Heloysa-Veloso-Fernandes/Project-PCEIoT/Heloysa Veloso - PCEIoT/Project Outputs for Heloysa Veloso - PCEIoT/BOM/Bill of Materials-Heloysa Veloso - PCEIoT(Fabricação).xlsx

Line # | Name | Description | Designator | Revision Status | Quantity | Manufacturer 1 | Manufacturer Part Number 1 | Manufacturer Lifecycle 1 | Supplier 1 | Supplier Part Number 1 | Supplier Unit Price 1 | Supplier Subtotal 1
 | VJ0603Y103KXAAC | Multilayer Ceramic Capacitor, 0.01 uF, 50 V, ± 10%, X7R, 0603 [1608 Metric] | C1, C4, C5, C19 |  | 4 | Vishay | VJ0603Y103KXAAC | Volume Production
 | Capacitor 4.7µF +/-20% 10V 0603 | Chip Capacitor, 4.7µF +/-20%, 10V, 0603, Thickness 1 mm | C2, C3 |  | 2 | Kyocera AVX | 0603ZD475KAT2A
 | VJ0603Y104MXJCW1BC | Multilayer Ceramic Capacitor, 0.1 uF, 16 V, ± 20%, X7R, 0603 [1608 Metric] | C6, C7, C9, C11, C12, C13, C14, C15, C16, C17, C18, C20, C21, C22, C23, C24, C25, C26, C27, C28, C29 |  | 21 | Vishay | VJ0603Y104MXJCW1BC | Volume Production
 | C0603C101K5GACTU | Multilayer Ceramic Capacitor, 100 pF, 50 V, ï¿½ 10%, C0G (NP0), 0603 [1608 Metric] | C30 |  | 1 | KEMET | C0603C101K5GACTU | Volume Production
 | GRM188R60J106ME47D | Multilayer Ceramic Capacitor, 10 uF, 6.3 V, ± 20%, X5R, 0603 [1608 Metric] | C31 |  | 1 | Murata | GRM188R60J106ME47D | Volume Production
 | ASMT-YTB7-0AA02 | LED Tri-Color Blue/Green/Red 469nm/529nm/623nm Chip LED 6-Pin PLCC T/R | D2A, D2B, D2C |  | 3 | Avago | ASMT-YTB7-0AA02 | Volume Production
 | 19-217/R6C-AL1M2VY/3T | Chip LED, Red, 5 V, 25 mA, -40 to 85 degC, 2-Pin SMD (0603), RoHS, Tape and Reel | DS1 |  | 1 | Everlight | EL-19-217/R6C-ALM2VY/3T
 | 640456-2 | Connector 250V AC/DC 5A 2P 1 Row PCB - Vertical Mounting Polyester White | J3 |  | 1 | TE Connectivity | 640456-2 | Volume Production
 | 61302011821 | THT Vertical Socket Header WR-PHD, Pitch 2.54 mm, Single Row, 20 pins | J4, J5 |  | 2 | Wurth Elektronik | 61302011821
 | 61300811821 | Btb Conn, Rcpt, 8Pos, 1Row, 2.54Mm Rohs Compliant: Yes | J6, J7, J8, J9 |  | 4 | Wurth Elektronik | 61300811821
 | BLM21PG331SN1D | IND, Chip Ferrite Bead, 330 Ohm, +/- 25%, 1.5 A, -55 to 125 degC, 0805 (2012 Metric), Tape and Reel | L1, L2 |  | 2 | Murata | LQG15HS15NJ02D | Volume Production
 | 709670110 | Pcb Mounting, Nylon 6.6, 11Mm Rohs Compliant: Yes | M1, M2, M7, M8 |  | 4 | Wurth Elektronik | 709670110
 | 970080354 | WA-SBRII Brass Spacer Stud Metric Thread int./int. | M3, M4, M9, M10 |  | 4 | Wurth Elektronik | 970080354
 | MPMS 003 0005 PH | Mach Screw Pan Head Phillips M3 | M5, M6, M11, M12 |  | 4 | Building Fasteners | MPMS 003 0005 PH
 | CMEJ-0415-42-LP | 4.0 mm, Omnidirectional, PCB Mount, 2.0 Vdc, Elecret Condenser Microphone | MK1 |  | 1 | Same Sky | CMEJ-0415-42-LP | Volume Production
 | 22-28-4033 | KK 254 Breakaway Header Vertical 3 Circuits 0.38um Gold Selective Plating Mating Pin 6.09mm | P1 |  | 1 | Molex | 22-28-4033 | Volume Production
 | NTRV4101PT1G | NTRV4101PT1G P-channel MOSFET Transistor; 1.7 A; 20 V; 3-Pin SOT-23 | Q1, Q2, Q3 |  | 3 | onsemi | NTRV4101PT1G | Volume Production
 | Resistor 1k +/-1% 0603 100 mW | Chip Resistor, 1 KOhm, +/-1%, 0.1 W, -55 to 155 degC, 0603 (1608 Metric) | R1, R38, R41, R45 |  | 4 | Yageo Group | RC0603FR-131KL | Volume Production
 | Resistor 10k +/-1% 0603 100 mW | Chip Resistor, 10 KOhm, +/- 1%, 01 W, -55 to 155 degC, 0603 (1608 Metric) | R2, R3, R4, R8, R11, R12, R13, R14, R18, R21, R22, R23, R26, R27, R36, R37, R44 |  | 17 | Panasonic | ERJ-3EKF1002V | Volume Production
 | Resistor 0R +/- 5% 0603 100 mW | Chip Resistor, 0 Ohm, 0.1 W, -55 to 155 degC, 0603 (1608 Metric) | R5, R7, R10, R30, R31 |  | 5 | Vishay | CRCW0603-0000Z0EA
 | CRCW0603150RFKEA | SMD Chip Resistor, 150 Ohm, ± 1%, 100 mW, 0603 [1608 Metric], Thick Film, General Purpose | R15A, R15B, R15C |  | 3 | Vishay | CRCW0603150RFKEA | Volume Production
 | CRCW060350R0FKEA | SMD Chip Resistor, 50 Ohm, ± 1%, 100 mW, 0603 [1608 Metric], Thick Film, General Purpose | R16A, R16B, R16C, R17A, R17B, R17C |  | 6 | Vishay | CRCW060350R0FKEA | Volume Production
 | ERJ-3EKF2001V | SMD Chip Resistor, 2 kOhm, ï¿½ 1%, 100 mW, 0603 [1608 Metric], Thick Film, Precision | R32 |  | 1 | Panasonic | ERJ-3EKF2001V | Volume Production
 | CRCW0603470RJNEA | Res Thick Film 0603 470 Ohm 5% 0.1W(1/10W) ±200ppm/°C Pad SMD Automotive T/R | R33 |  | 1 | Vishay | CRCW0603470RJNEA | Volume Production
 | ERJ-3EKF3300V | SMD Chip Resistor, 330 Ohm, ± 1%, 100 mW, 0603 [1608 Metric], Thick Film, Precision | R34 |  | 1 | Panasonic | ERJ-3EKF3300V | Volume Production
 | CRCW06032K20FKEA | SMD Chip Resistor, 2.2 kOhm, ± 1%, 100 mW, 0603 [1608 Metric], Thick Film, General Purpose | R35, R43 |  | 2 | Vishay | CRCW06032K20FKEA | Volume Production
 | Resistor 100k +/-1% 0603 100 mW | Chip Resistor, 100 KOhm, +/- 1%, 0.1 W, -55 to 155 degC, 0603 (1608 Metric) | R39, R40 |  | 2 | Vishay | CRCW0603-100KFKEA
 | TC33X-2-104E | Cermet trimmer potentiometer, 100 kΩ, 0.1 W, SMD, on top, TC33X-2-104E | R42 |  | 1 | Bourns | TC33X-2-104E | Volume Production
 | 5033981892 | Micro SD Card Connector, Pitch 1.1 mm, 8 Position, Height 1.4 mm, -25 to 85 degC, RoHS, Tape and Reel | SKT1 |  | 1 | Molex | 503398-1892 | Volume Production
 | FSM4JSMA | Switch Tactile OFF (ON) SPST Round Button Gull Wing 0.05A 12VDC 1.57N SMD Loose Piece | SW1, SW2, SW3 |  | 3 | TE Connectivity | FSM4JSMA
 | OPT4001DTSR | High-speed high-precision digital ambient light sensor (ALS) 8-SOT-5X3 -40 to 85 | U1 |  | 1 | Texas Instruments | OPT4001DTSR | Volume Production
 | SHT40I-AD1B-R3 | Humidity And Temperature Sensor | U2 |  | 1 | Sensirion | SHT40I-AD1B-R3 | Volume Production
 | ICM-42670-P | Mems Module, 1.71-3.6 V, Lga-14 Rohs Compliant: Yes | U3 |  | 1 | TDK | ICM-42670-P | Volume Production
 | SX1509BIULTRT | IC Gpio Expander I2C 16CH 28QFN / I2C Interface 5.5V 28-PIN Qfn-ut Ep T/r | U4 |  | 1 | Semtech | SX1509BIULTRT | Volume Production
 | MS563702BA03-50 | Pressure Sensor, Barometric, 300 mbar, 1200 mbar, QFN, 8, -40 C | U5 |  | 1 | Measurement Specialties | MS563702BA03-50
 | LM4040DYM3-2.5-TR | LM4040 Series 2.5 V ±1 % Precision Micropower Shunt Voltage Reference - SOT-23 | U6 |  | 1 | Microchip | LM4040DYM3-2.5-TR | Volume Production
 | SC0918 | Raspberry Pi Pico W RP2040 | U7 |  | 1 | Raspberry Pi | SC0918
 | MAX4466EXK-T | Audio Amp Microphone 1-CH Mono Class-AB 5-Pin SC-70 T/R | U8 |  | 1 | Analog Devices Inc./Maxim Integrated | MAX4466EXK+T | Manual Solution | DigiKey | MAX4466EXK+CT-ND | 0.88 | 0.88
 | MCP73831T-2ACI/OT | MCP73831 Series Single-Cell Li-Ion/Li-Polymer Battery Charge Controller SOT-23-5 | U9 |  | 1 | Microchip | MCP73831T-2ACI/OT | Volume Production
 | BQ29700DSER | Li-Ion/Li Polymer Advanced Single-Cell Battery Protector IC Family 6-WSON -40 to 85 | U10 |  | 1 | Texas Instruments | BQ29700DSER | Volume Production
