Heloysa-Veloso-Fernandes/Project-PCEIoT/Heloysa Veloso - PCEIoT/Project Outputs for Heloysa Veloso - PCEIoT/Heloysa Veloso - PCEIoT.pdf

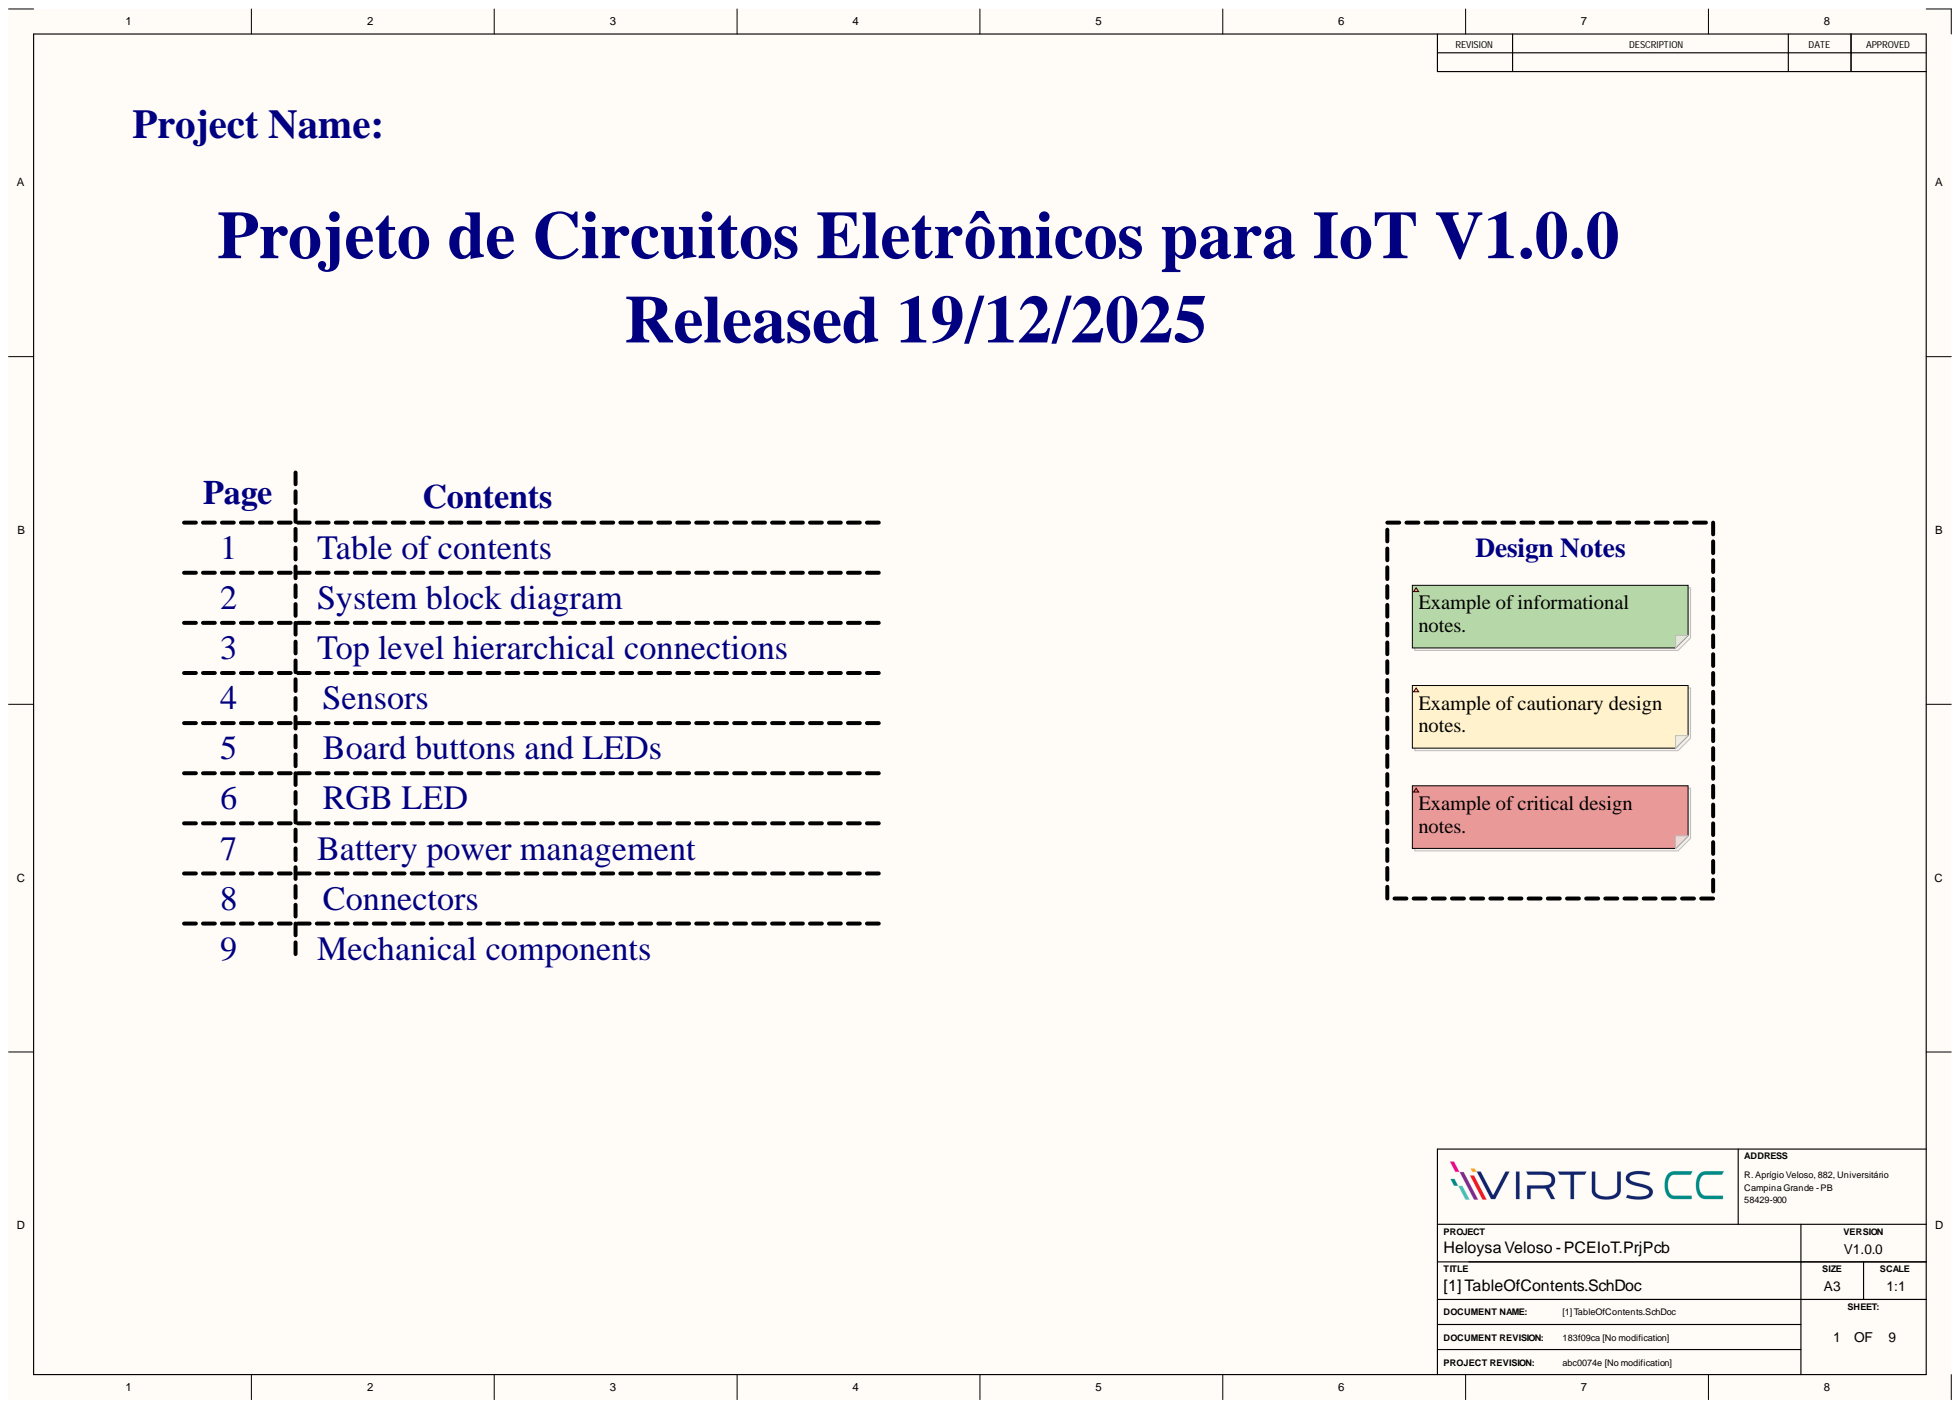
[picture p1: page 1]

Project Name:
Projeto de Circuitos Eletrônicos para IoT V1.0.0

Example of cautionary design
notes.

Example of critical design

ADDRESS R.Aprígio Veloso, 882, Universitário Campina Grande - PB 58429-900

PROJECT Heloysa Veloso - PCEIoT.PrjPcb | VERSION V1.0.0

TITLE [1] TableOfContents.SchDoc | SIZE A3 | SCALE 1:1

DOCUMENT NAME: [1] TableOfContents.SchDoc | SHEET: OF

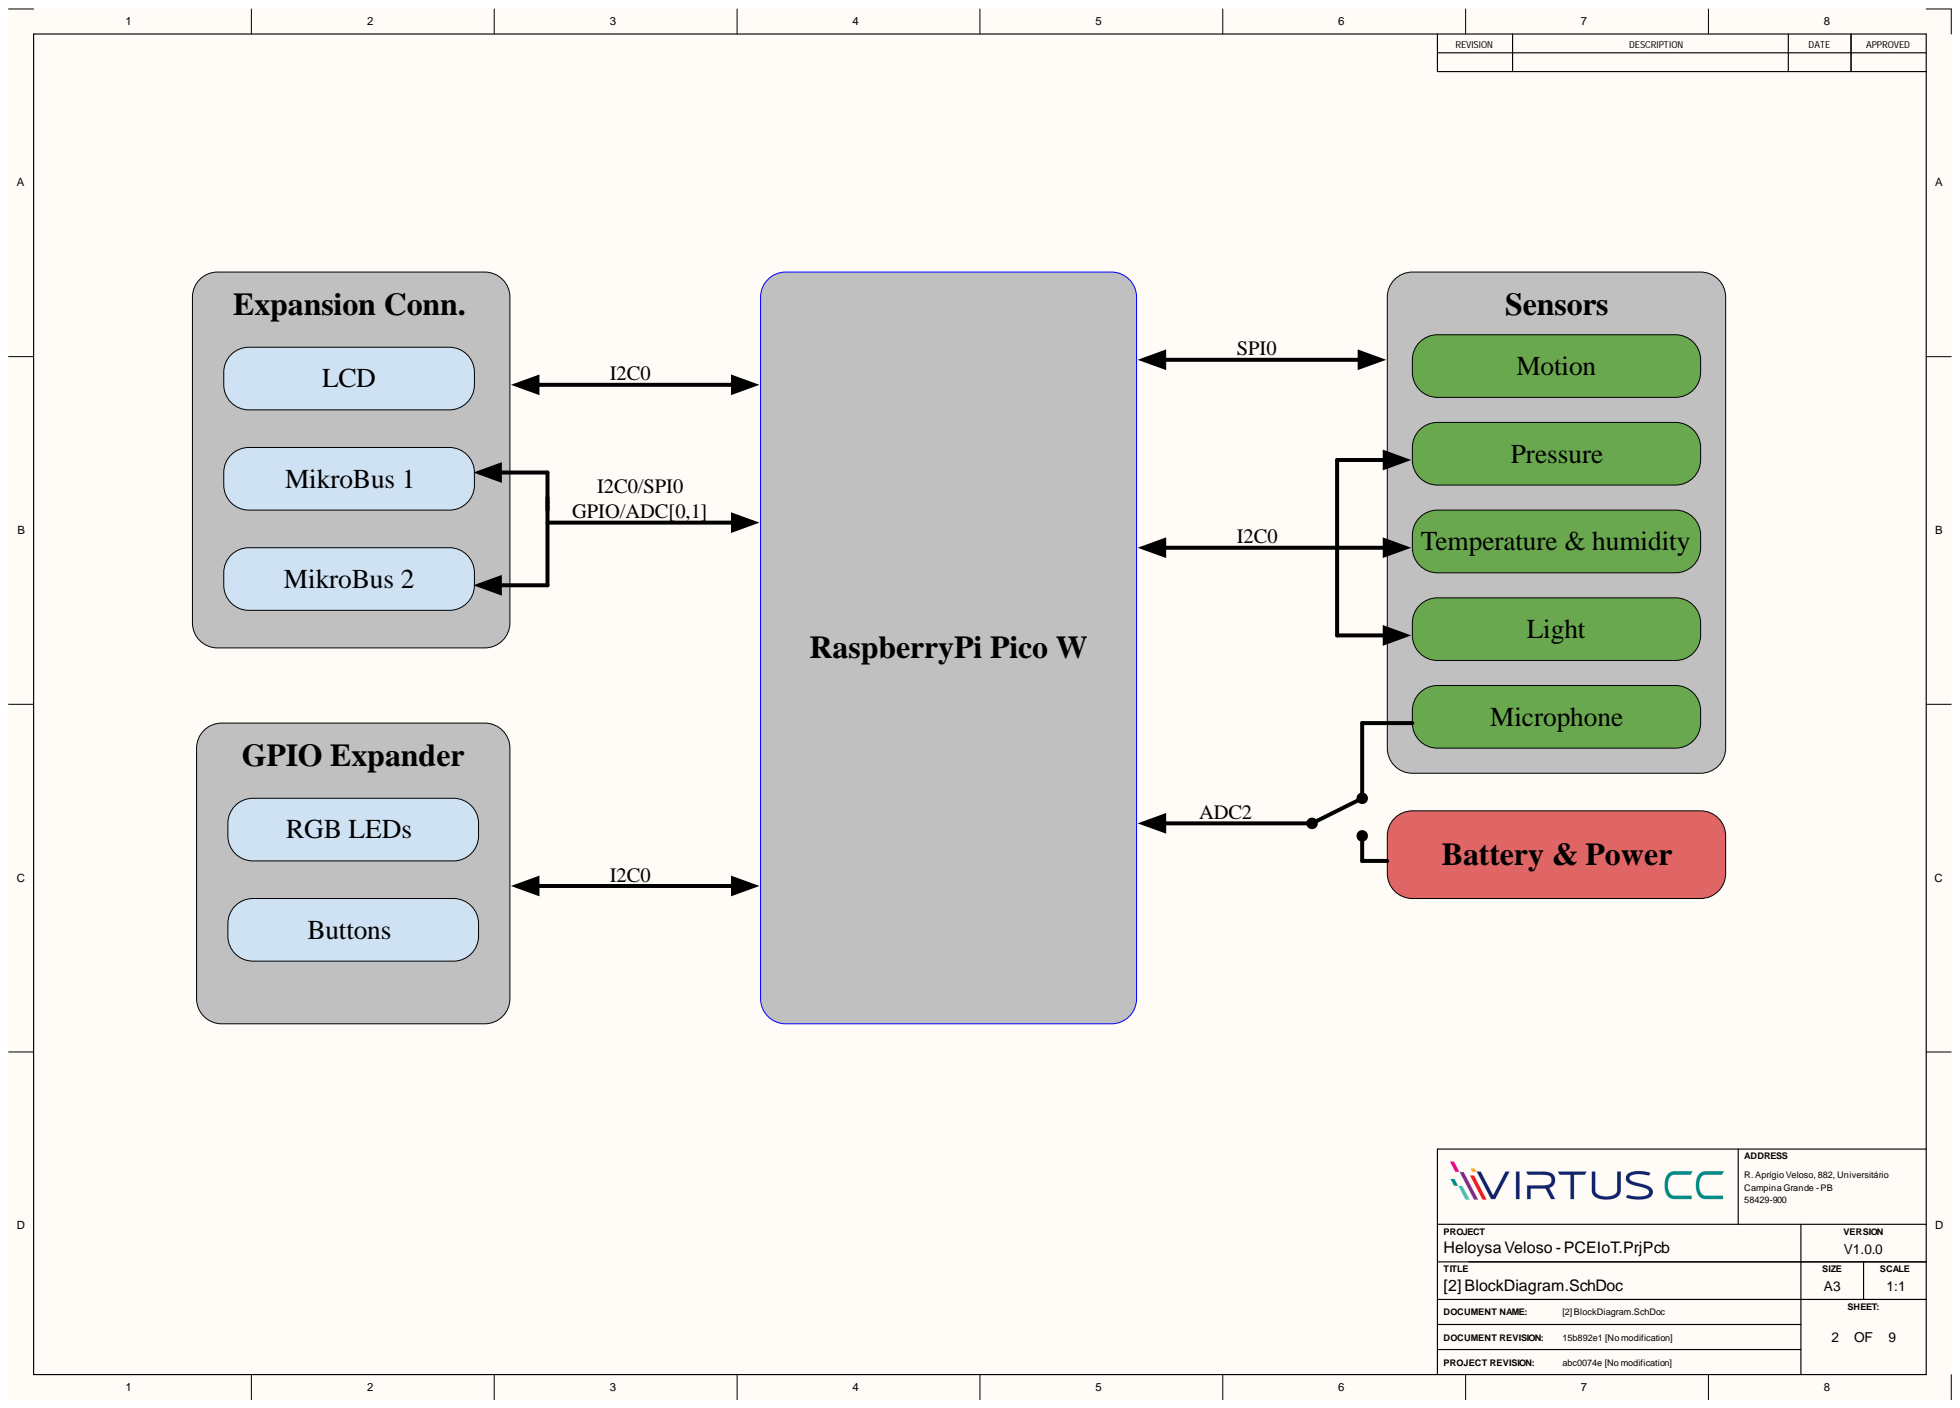
[picture p2: page 2]

ADDRESS R.Aprígio Veloso, 882, Universitário Campina Grande - PB 58429-900

PROJECT Heloysa Veloso - PCEIoT.PrjPcb | VERSION V1.0.0

TITLE [2] BlockDiagram.SchDoc | SIZE A3 | SCALE 1:1

[2] BlockDiagram.SchDoc

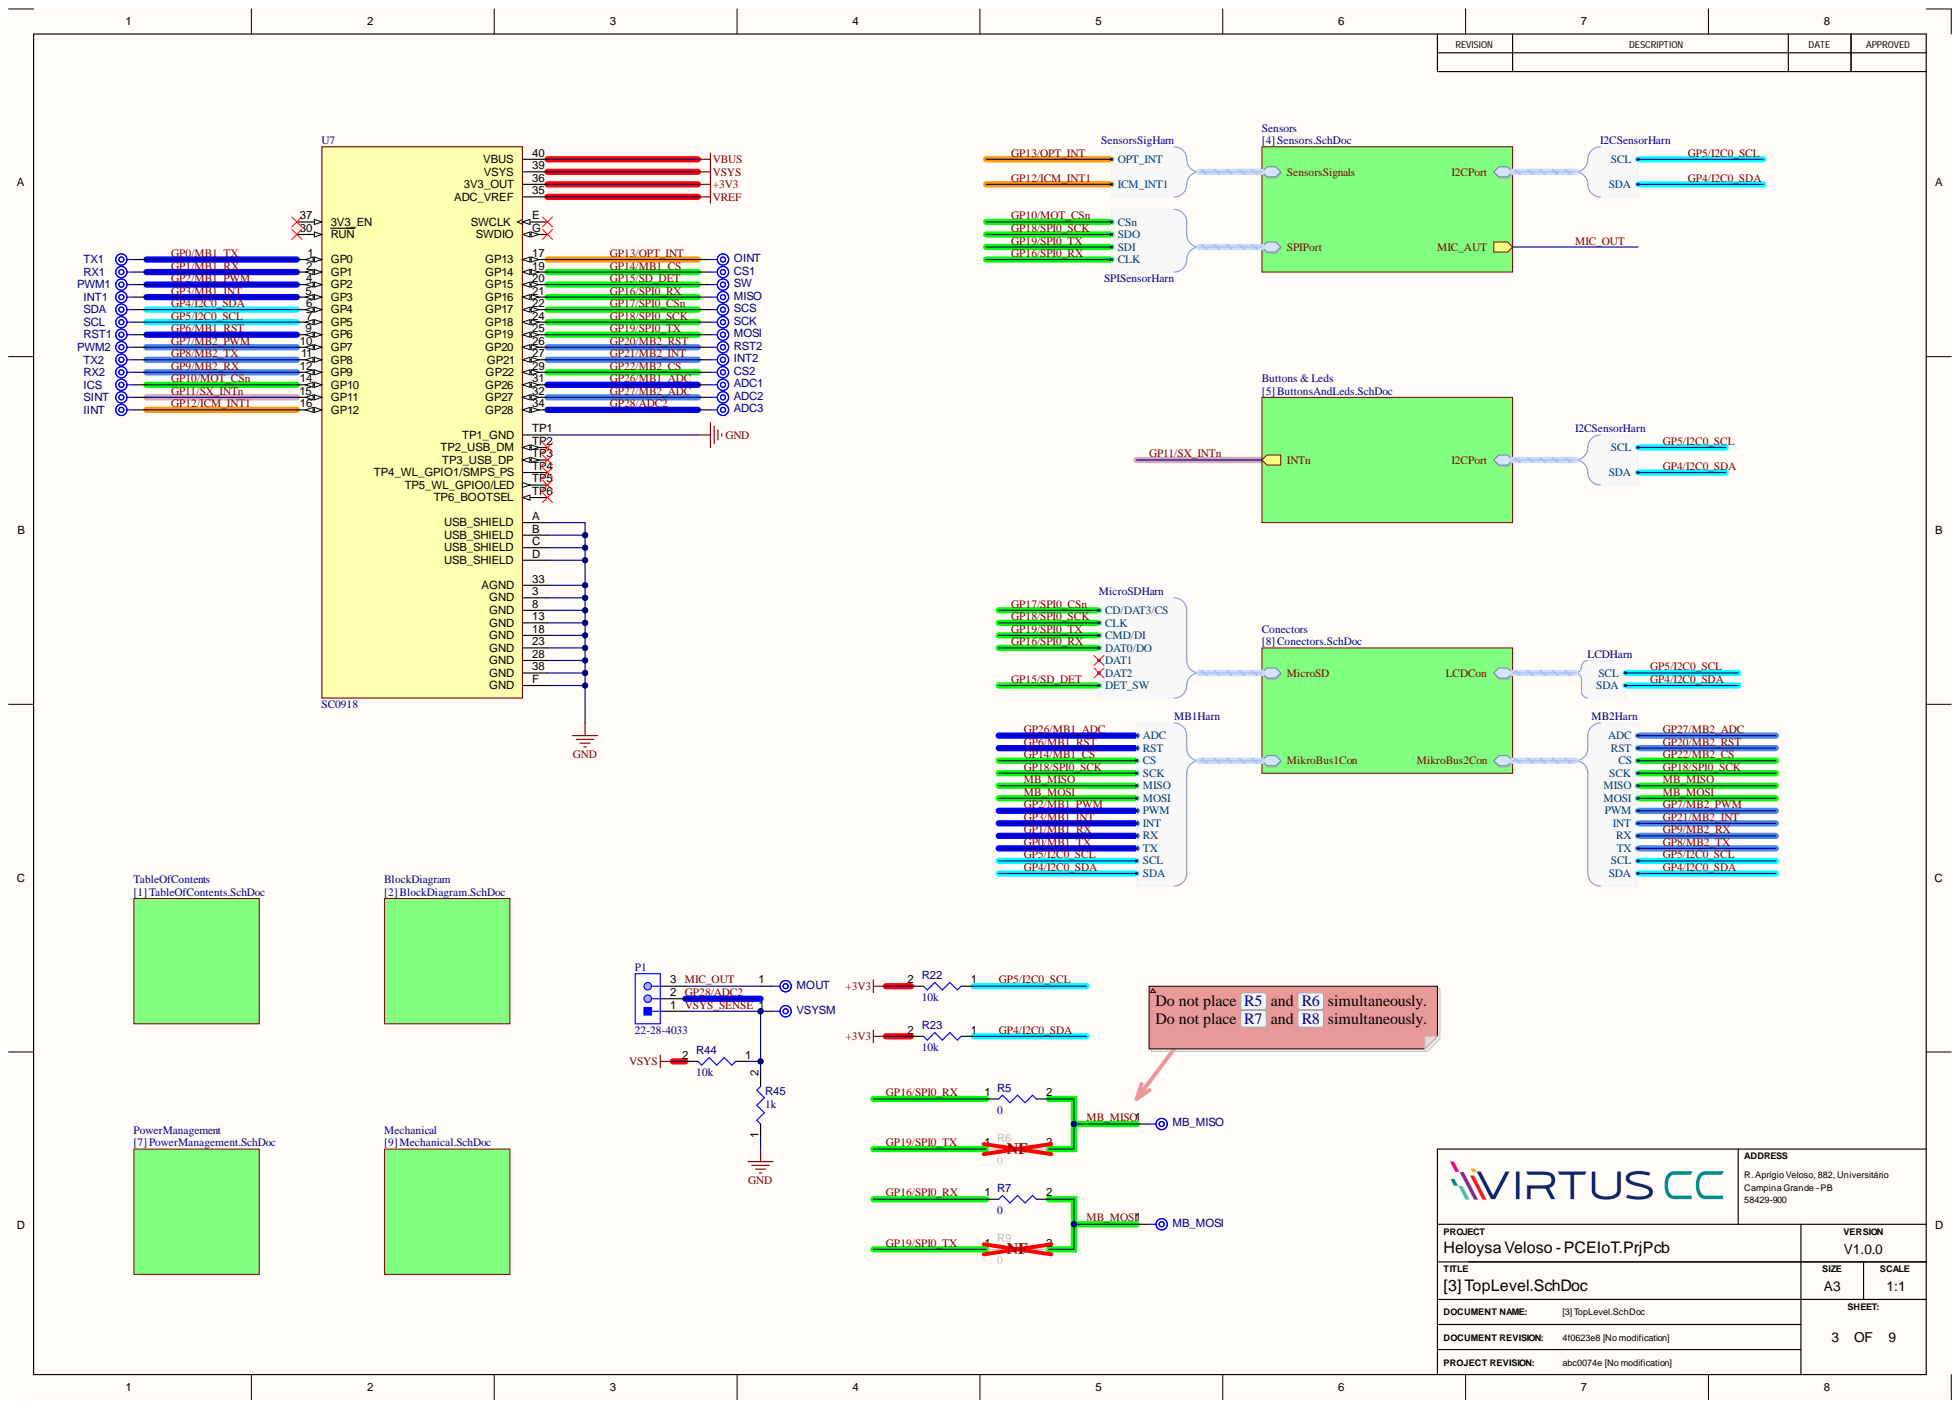
[picture p3: page 3]

Do not place R5 and R6 simultaneously.
Do not place R7 and R8 simultaneously.

ADDRESS R.Aprígio Veloso, 882, Universitário Campina Grande - PB 58429-900

PROJECT Heloysa Veloso - PCEIoT.PrjPcb | VERSION V1.0.0

TITLE [3] TopLevel.SchDoc | SIZE A3 | SCALE 1:1

[3] TopLevel.SchDoc

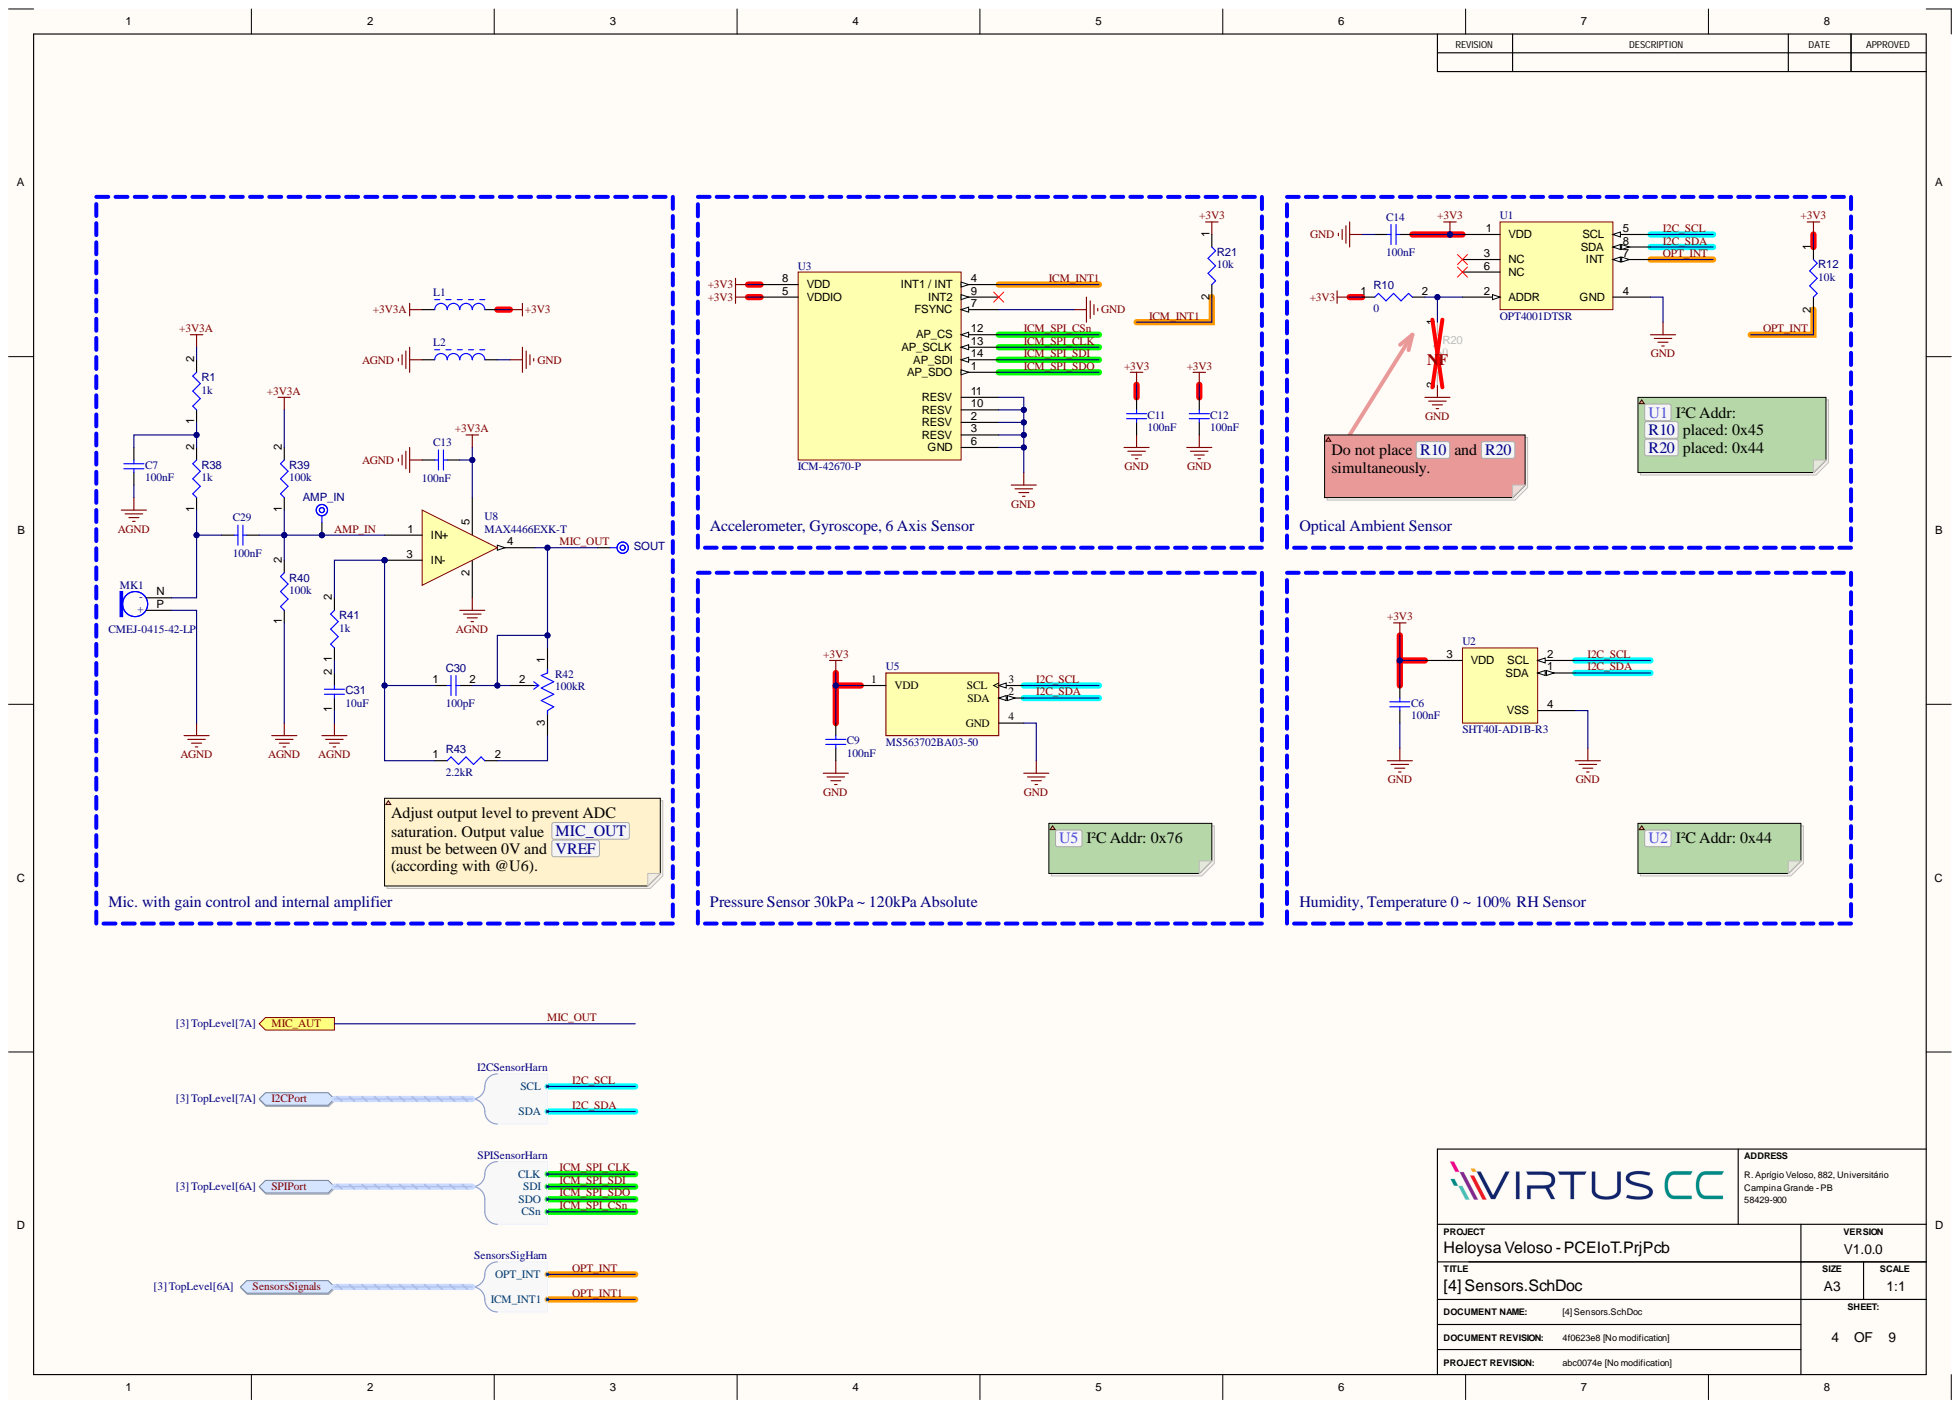
[picture p4: page 4]

Adjust output level to prevent ADC
saturation. Output value MIC_OUT
must be between 0V and VREF
(according with @U6).

Mic. with gain control and internal amplifier

Humidity, Temperature 0 ~ 100% RH Sensor

ADDRESS R.Aprígio Veloso, 882, Universitário Campina Grande - PB 58429-900

PROJECT Heloysa Veloso - PCEIoT.PrjPcb | VERSION V1.0.0

TITLE [4] Sensors.SchDoc | SIZE A3 | SCALE 1:1

[4] Sensors.SchDoc

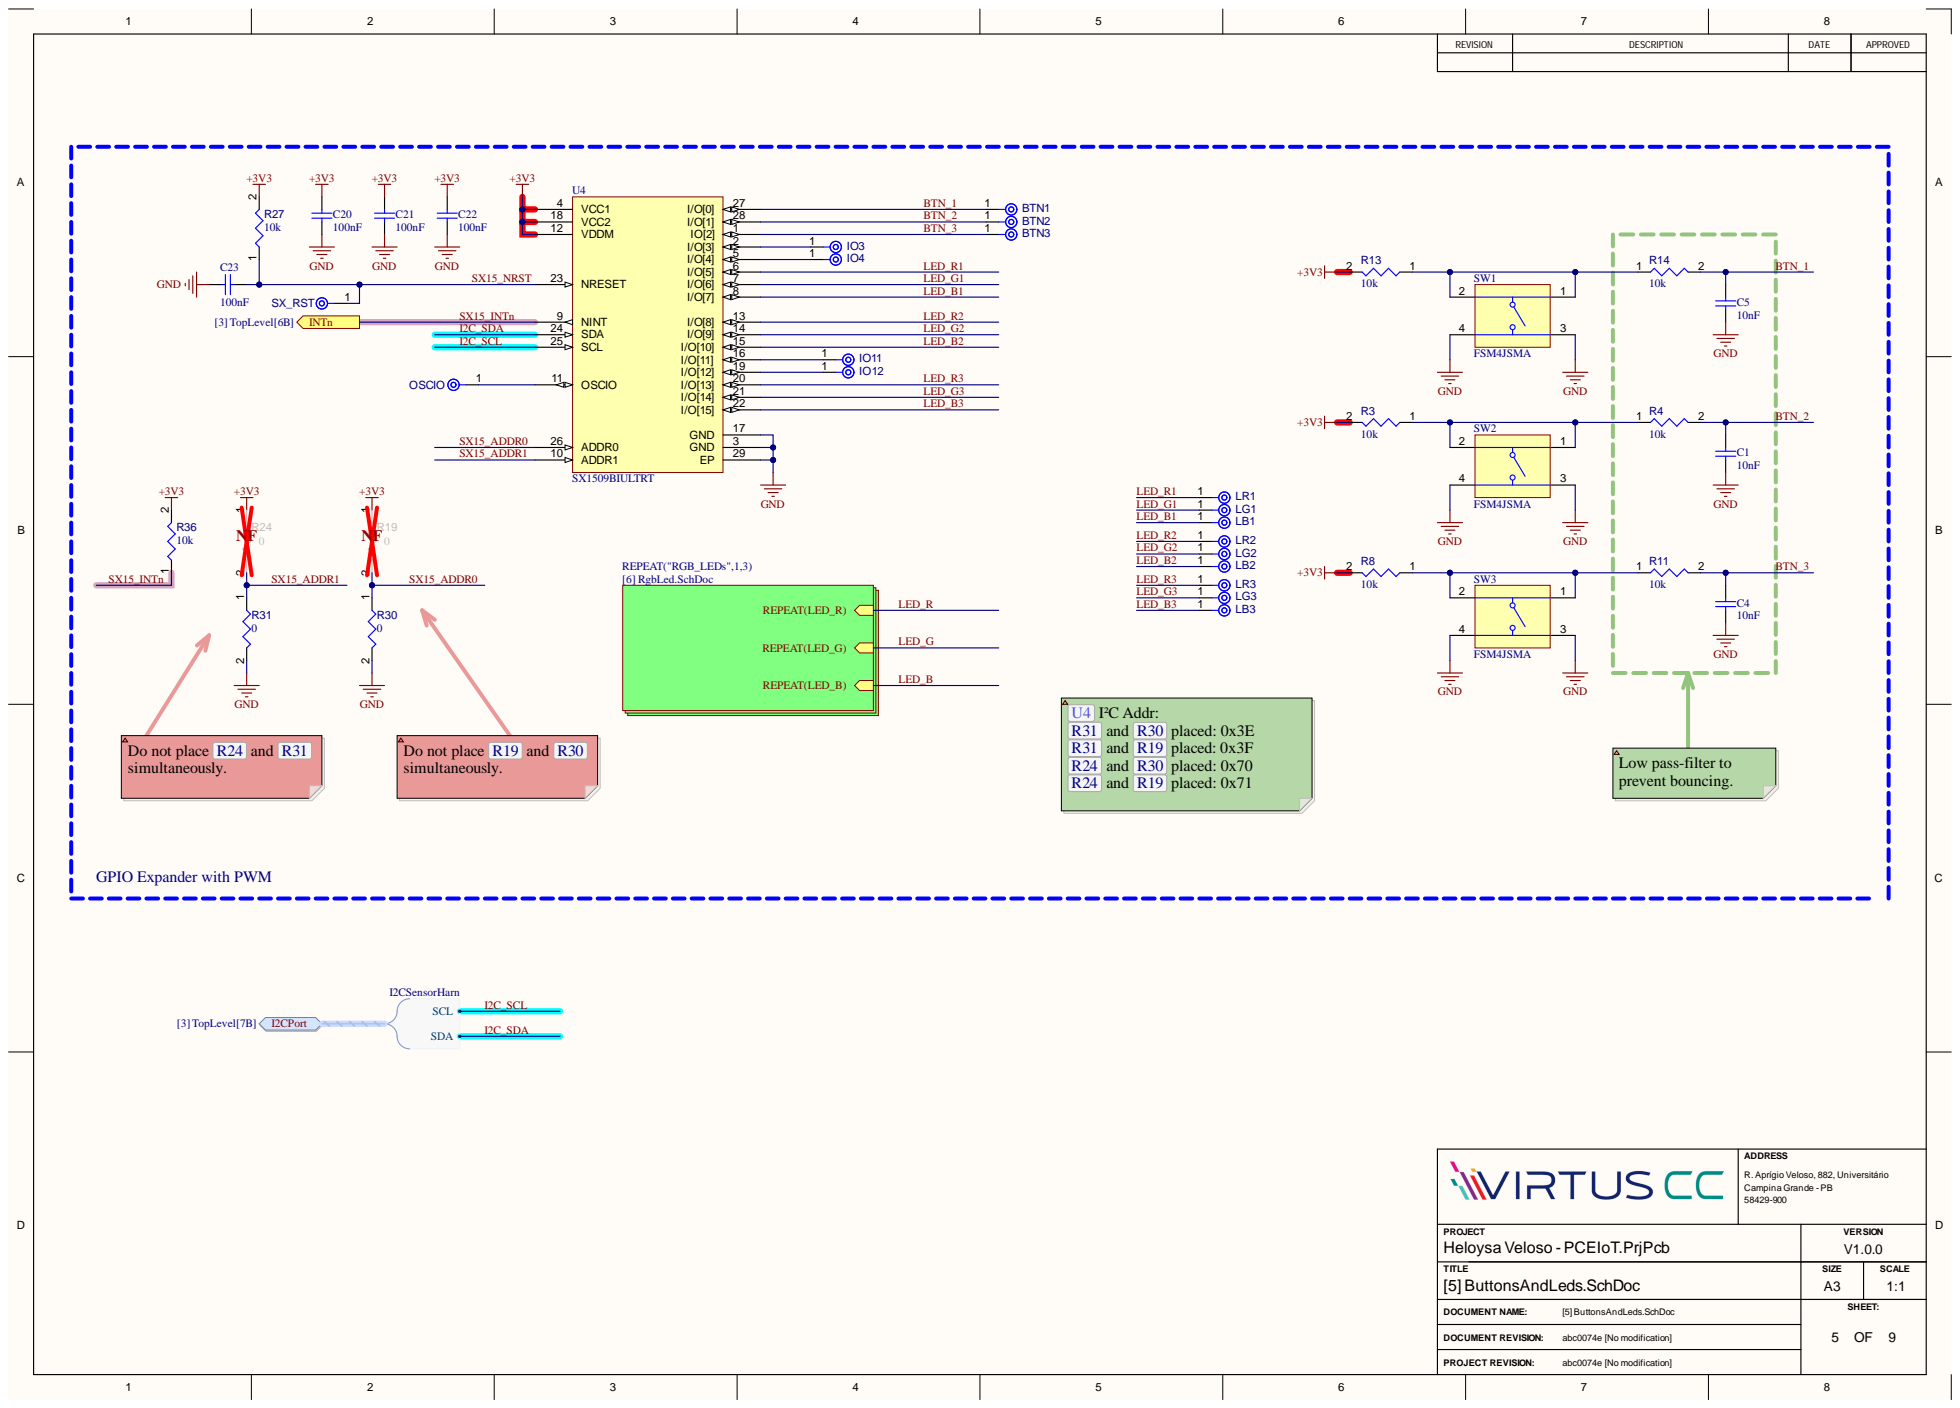
[picture p5: page 5]

VCC2 18
VDDM 12

Do not place R24 and R31
simultaneously.

Do not place R19 and R30

Low pass-filter to
prevent bouncing.

GPIO Expander with PWM

ADDRESS R.Aprígio Veloso, 882, Universitário Campina Grande - PB 58429-900

PROJECT Heloysa Veloso - PCEIoT.PrjPcb | VERSION V1.0.0

TITLE [5] ButtonsAndLeds.SchDoc | SIZE A3 | SCALE 1:1

[5] ButtonsAndLeds.SchDoc

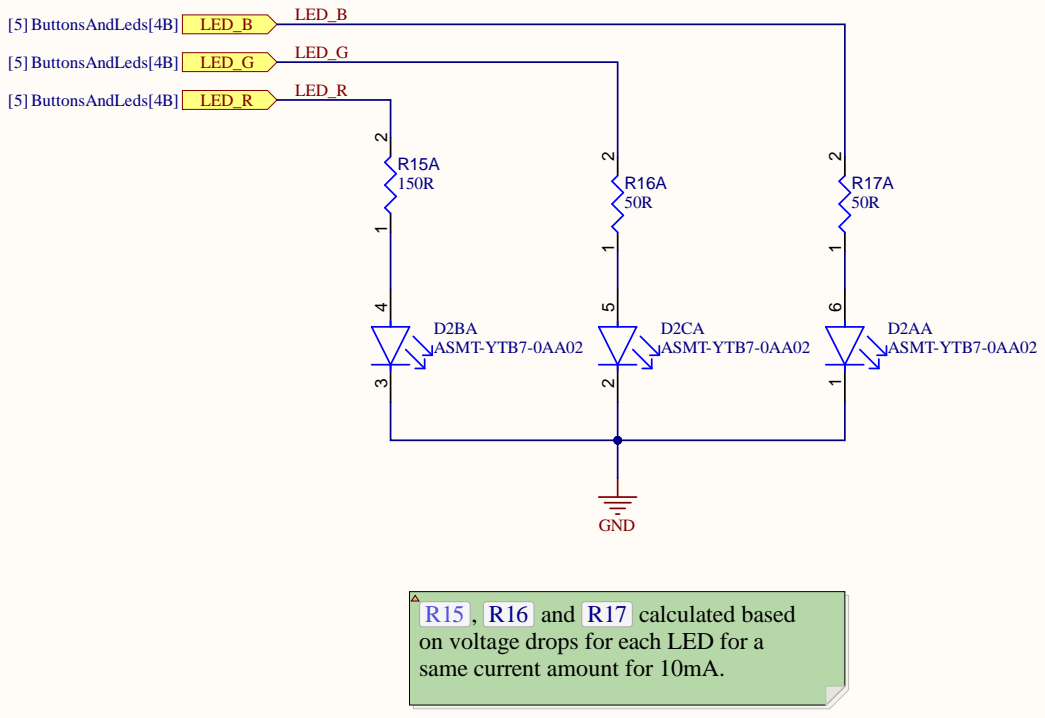
[picture p6: page 6]

R15 , R16 and R17 calculated based
on voltage drops for each LED for a
same current amount for 10mA.

ADDRESS R.Aprígio Veloso, 882, Universitário Campina Grande - PB 58429-900

PROJECT Heloysa Veloso - PCEIoT.PrjPcb | VERSION V1.0.0

TITLE [6] RgbLed.SchDoc | SIZE A3 | SCALE 1:1

[6] RgbLed.SchDoc

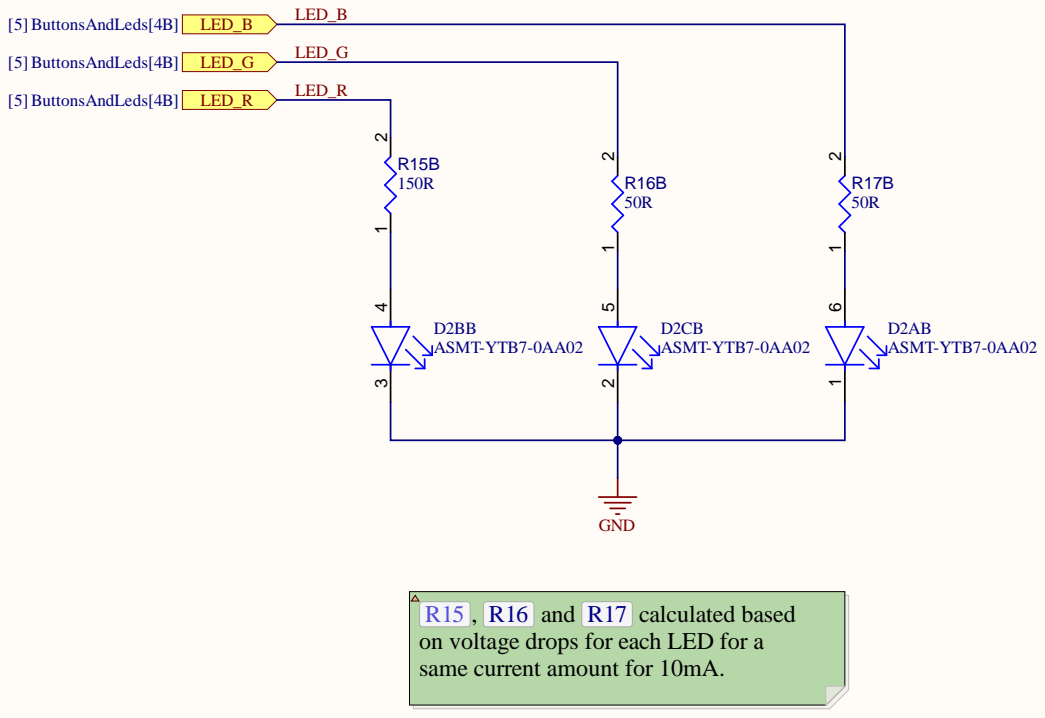
[picture p7: page 7]
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

ADDRESS R.Aprígio Veloso, 882, Universitário Campina Grande - PB 58429-900

PROJECT Heloysa Veloso - PCEIoT.PrjPcb | VERSION V1.0.0

TITLE [6] RgbLed.SchDoc | SIZE A3 | SCALE 1:1

[6] RgbLed.SchDoc

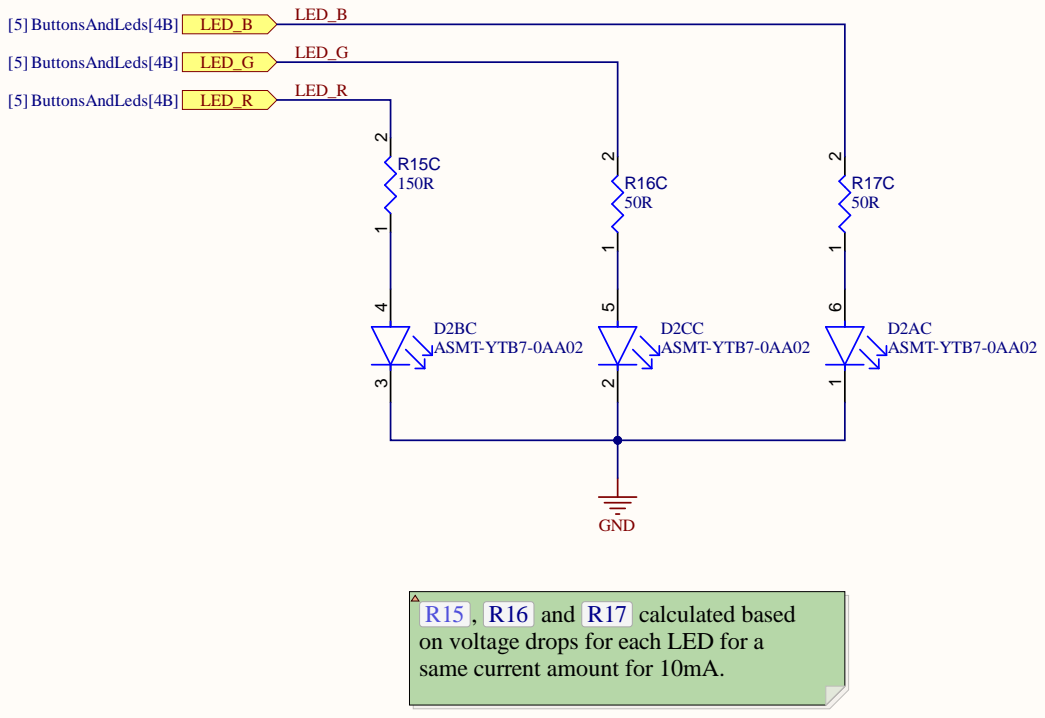
[picture p8: page 8]

on voltage drops for e
same curr

A D D R E S S R . Apr ígio Veloso, 882, U n iversi t á r i o Campi na G rande -P B 58429-9 0 0

P R OJ E C T Heloysa V eloso -PCEIo T.P rj P c b | V E R S I O N V1 . 0 . 0

D O C U M E N T N AM E : [6] RgbLed. Sch D o c | S H E E T: O F

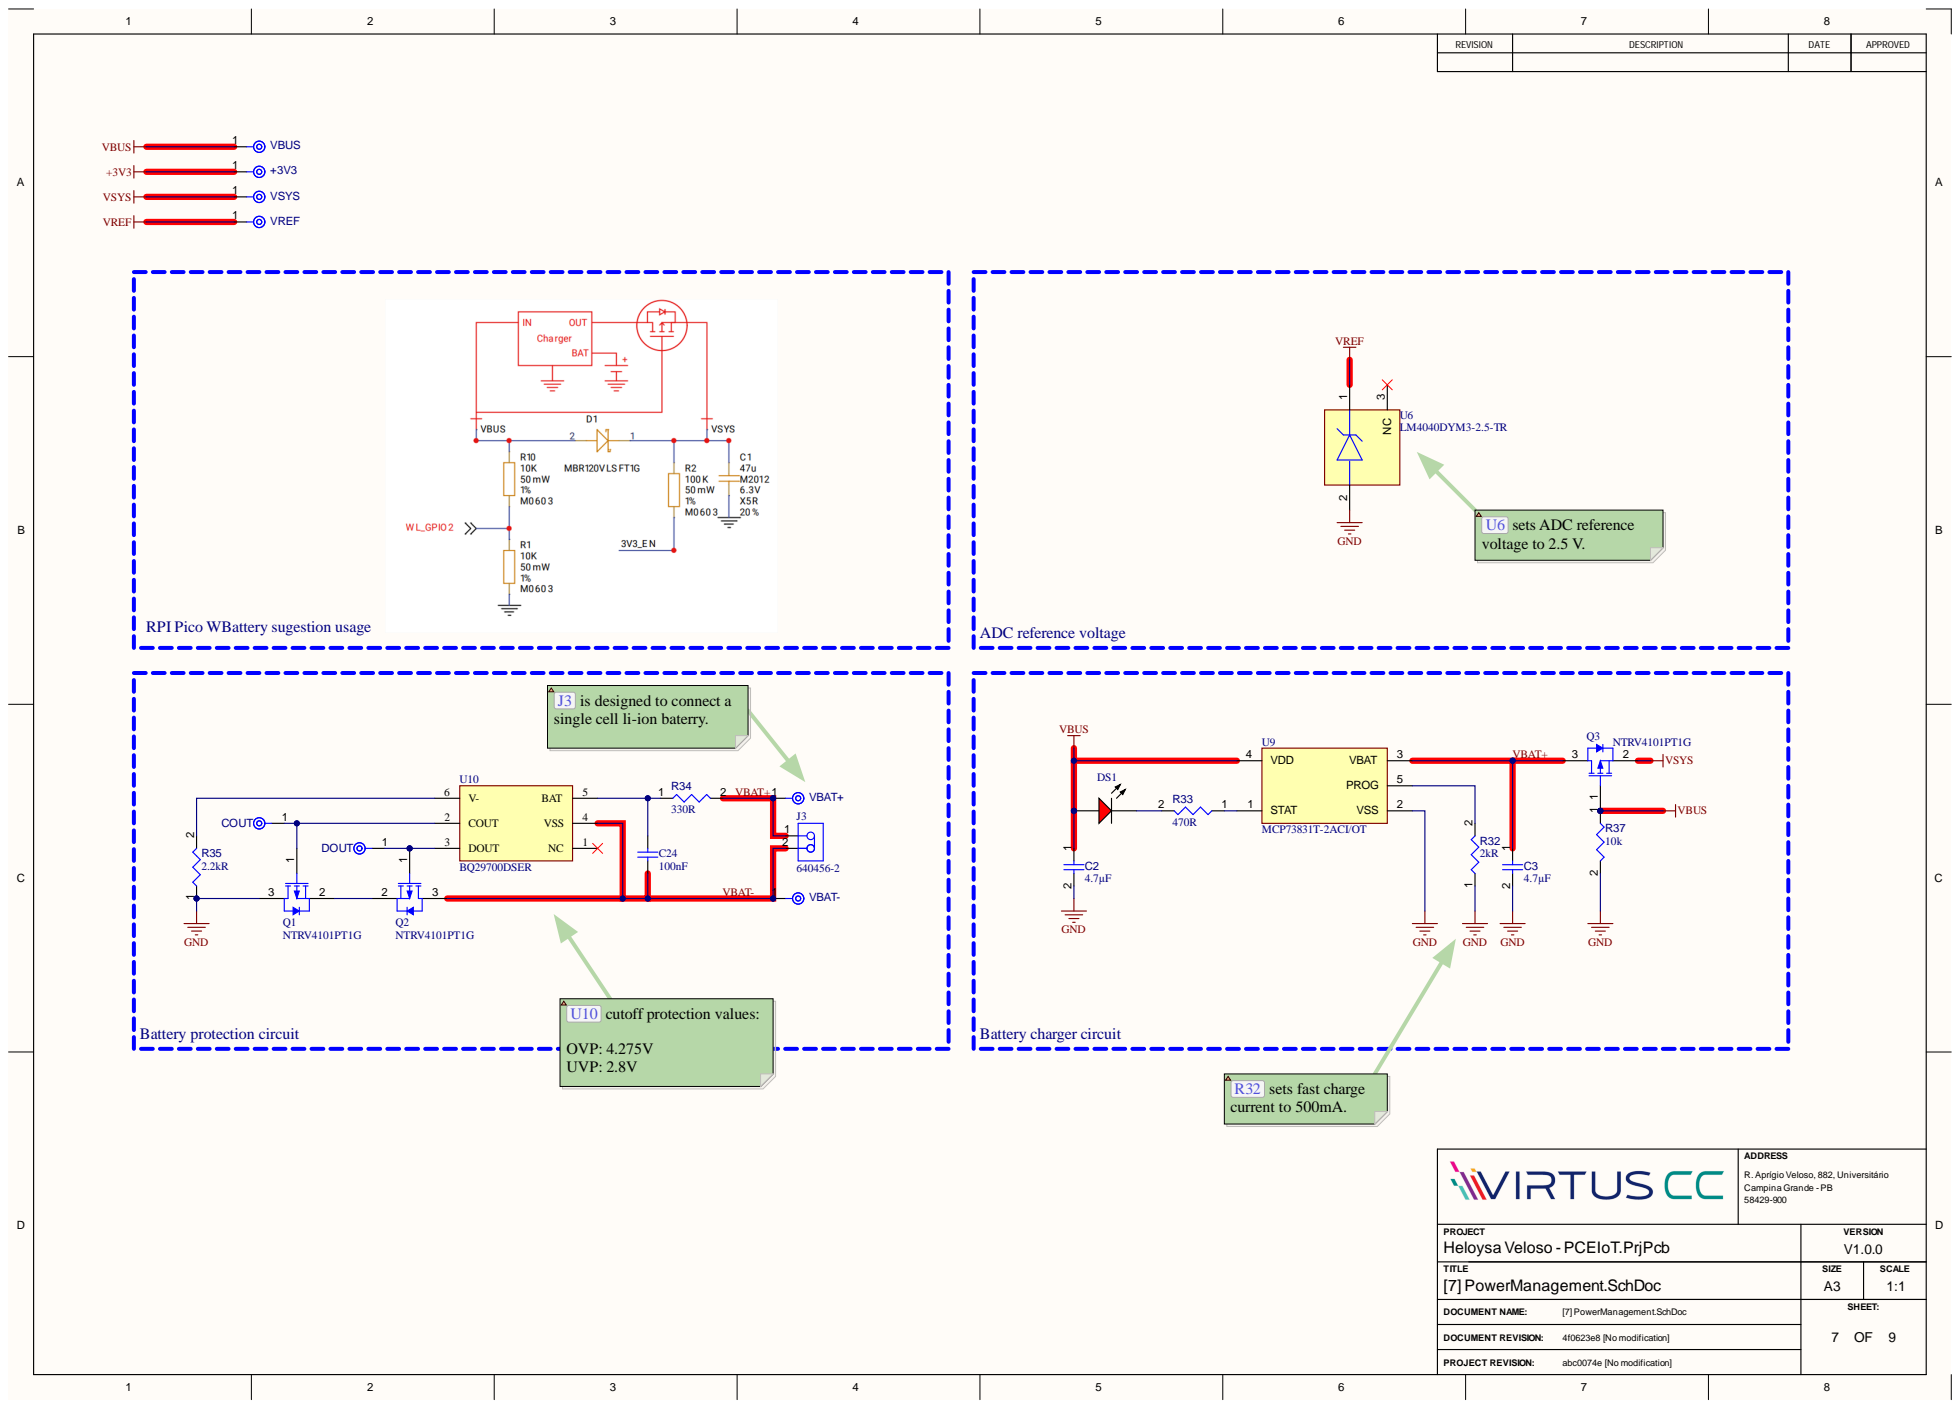
[picture p9: page 9]

RPI Pico WBattery sugestion usage

J3 is designed to connect a
single cell li-ion baterry.

ADDRESS R.Aprígio Veloso, 882, Universitário Campina Grande - PB 58429-900

PROJECT Heloysa Veloso - PCEIoT.PrjPcb | VERSION V1.0.0

TITLE [7] PowerManagement.SchDoc | SIZE A3 | SCALE 1:1

[7] PowerManagement.SchDoc

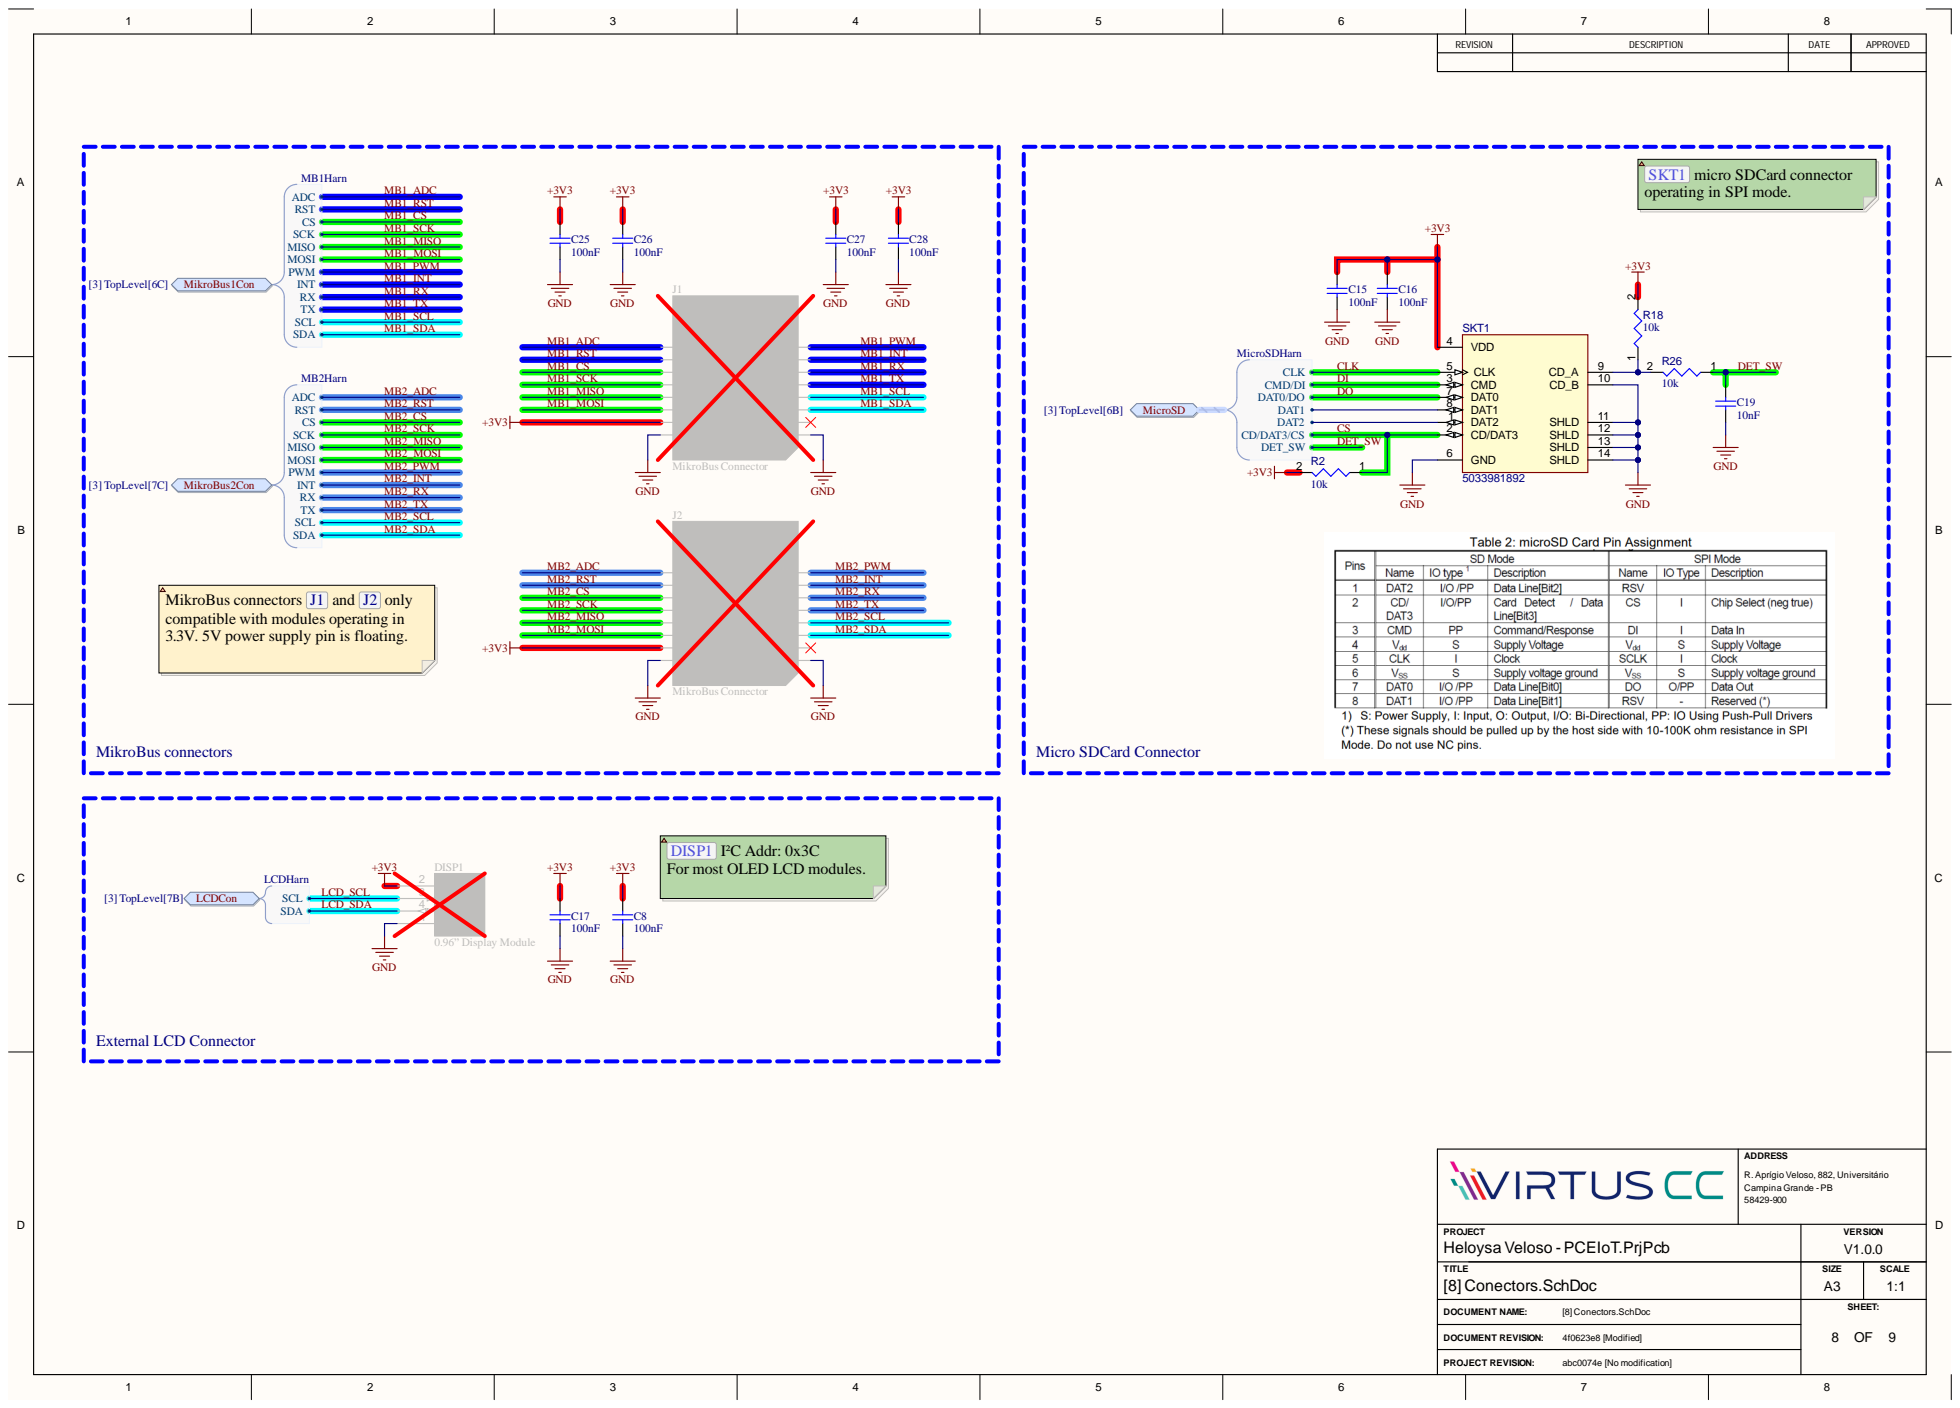
[picture p10: page 10]

MikroBus
compatible with modules ope
3.3V. 5V powe

r supply pin is floating.

For most OLED LCD modules.

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

T IT L E [8] Co n ecto rs.S c h D o c | S I Z E A3 | S C AL E 1 : 1

D O C U M E N T N AM E : [8] Conectors. Sch D o c | S H E E T: O F

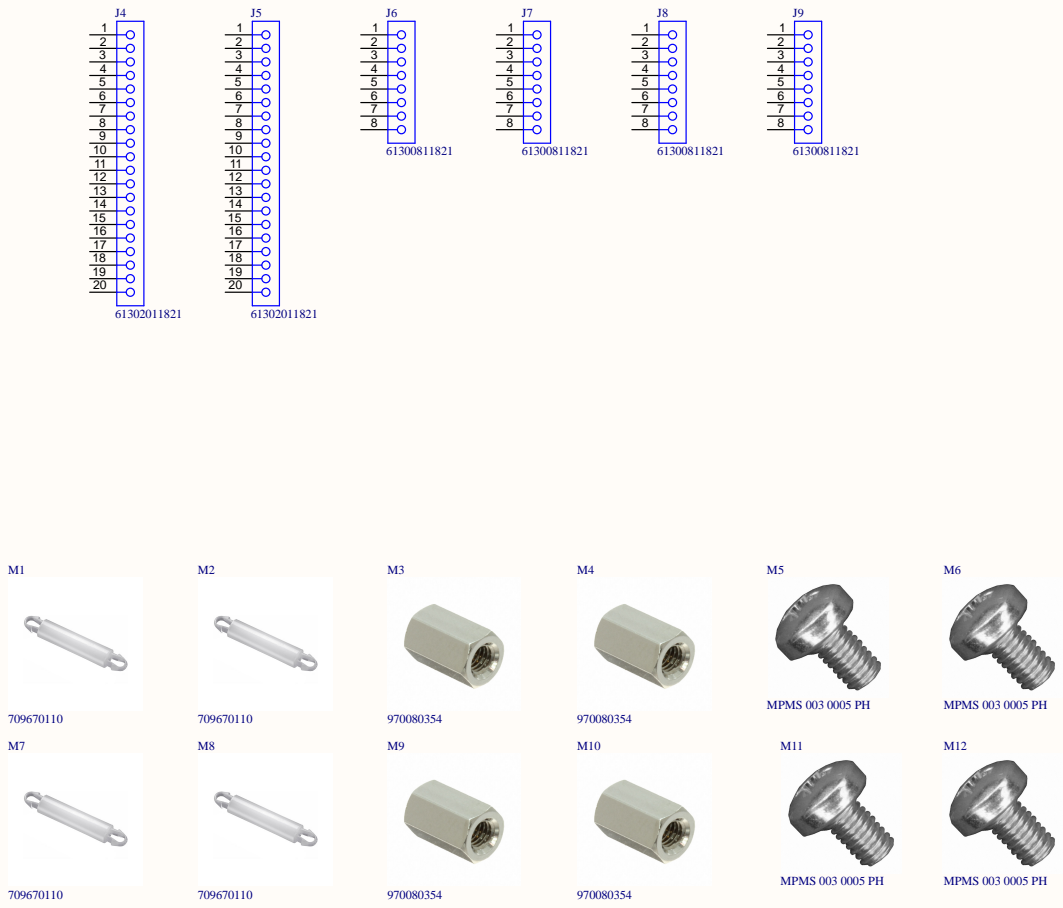
[picture p11: page 11]

ADDRESS R.Aprígio Veloso, 882, Universitário Campina Grande - PB 58429-900

PROJECT Heloysa Veloso - PCEIoT.PrjPcb | VERSION V1.0.0

TITLE [9] Mechanical.SchDoc | SIZE A3 | SCALE 1:1

[9] Mechanical.SchDoc
