Heloysa-Veloso-Fernandes/Project-PCEIoT/(list of files, drawings)

Other design files:
Heloysa Veloso - PCEIoT/Docs PrjPcb/Heloysa Veloso - PCEIoT.PrjPcb
Heloysa Veloso - PCEIoT/Sources/[1] TableOfContents.SchDoc
Heloysa Veloso - PCEIoT/Sources/[2] BlockDiagram.SchDoc
Heloysa Veloso - PCEIoT/Sources/[3] TopLevel.SchDoc
Heloysa Veloso - PCEIoT/Sources/[4] Sensors.SchDoc
Heloysa Veloso - PCEIoT/Sources/[5] ButtonsAndLeds.SchDoc
Heloysa Veloso - PCEIoT/Sources/[6] RgbLed.SchDoc
Heloysa Veloso - PCEIoT/Sources/[7] PowerManagement.SchDoc
Heloysa Veloso - PCEIoT/Sources/[8] Conectors.SchDoc
Heloysa Veloso - PCEIoT/Sources/[9] Mechanical.SchDoc
